williamlin108/Klondike-Connect-4---2026/PCB/3D/TMC2209.step

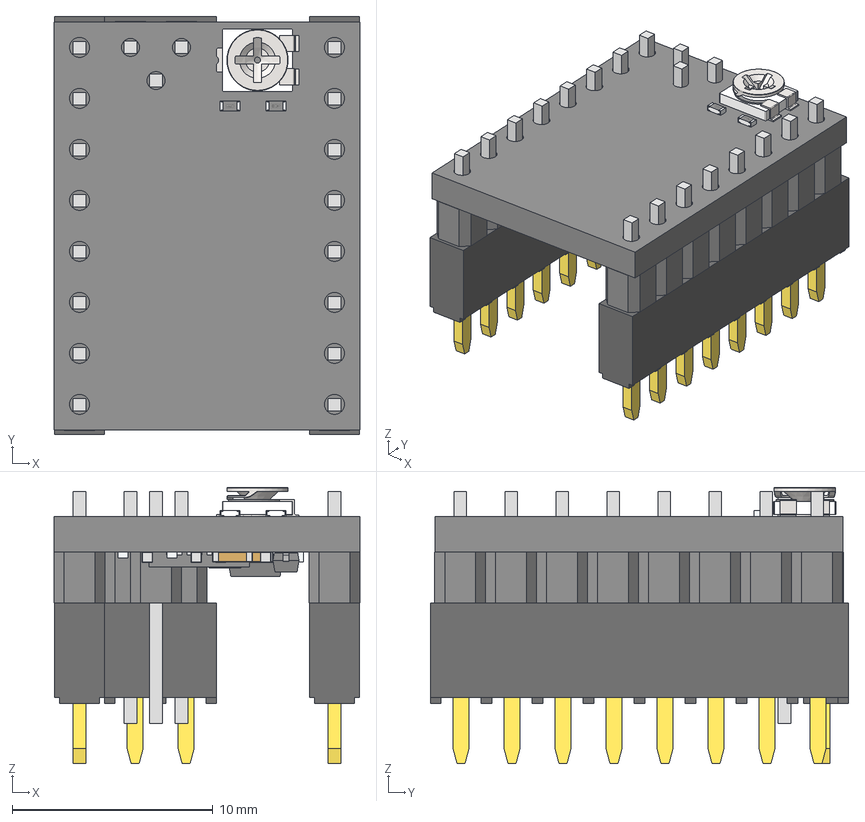
[picture p1: CAD file, 2026-09-19]
PCB/3D/TMC2209.step
15.2 x 20.8 x 13.8 mm
