williamlin108/Klondike-Connect-4---2026/PCB/3D/USB_C_Receptacle_GCT_USB4110.stp

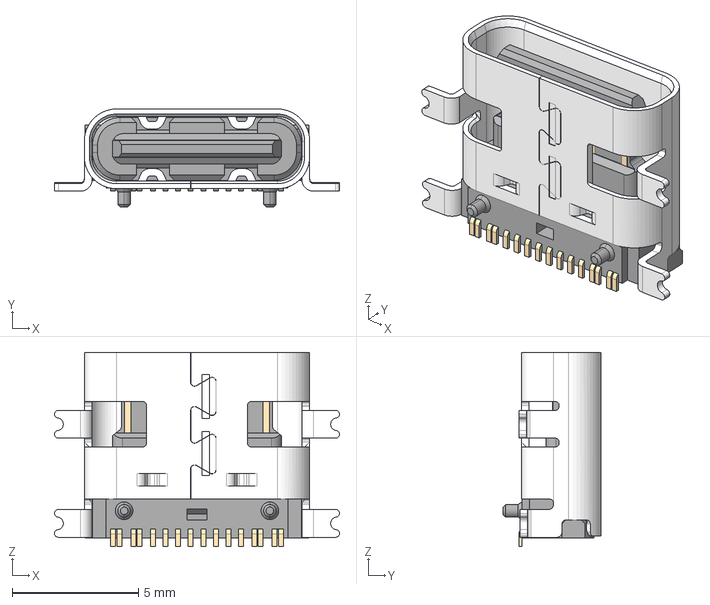
[picture p2: CAD file, 2026-09-18]
PCB/3D/USB_C_Receptacle_GCT_USB4110.stp
11.3 x 3.89 x 7.70 mm
