williamlin108/Klondike-Connect-4---2026/PCB/3D/ESP32-C3-MINI-1-N4.stp

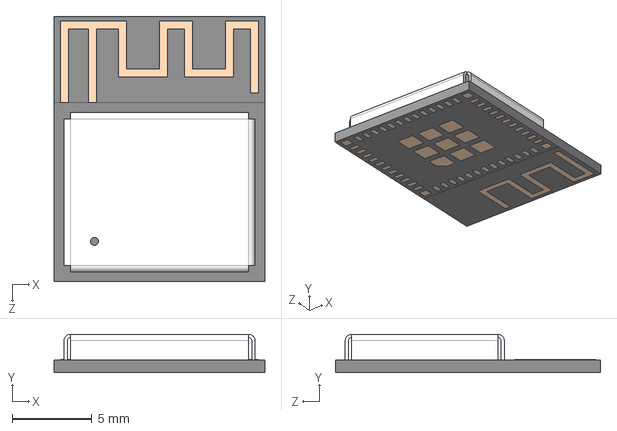
[picture p3: CAD file, 2026-09-18]
PCB/3D/ESP32-C3-MINI-1-N4.stp
13.2 x 2.40 x 16.6 mm
