williamlin108/Klondike-Connect-4---2026/PCB/3D/436500215.STEP

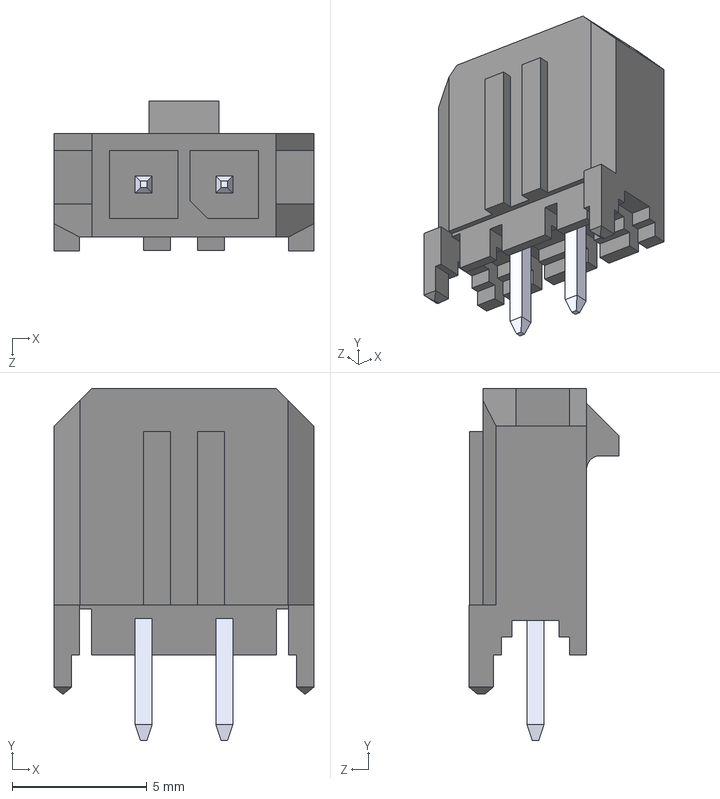
[picture p4: CAD file, 2026-10-14]
PCB/3D/436500215.STEP
9.65 x 13.1 x 5.57 mm
