williamlin108/Klondike-Connect-4---2026/PCB/3D/436500201.stp

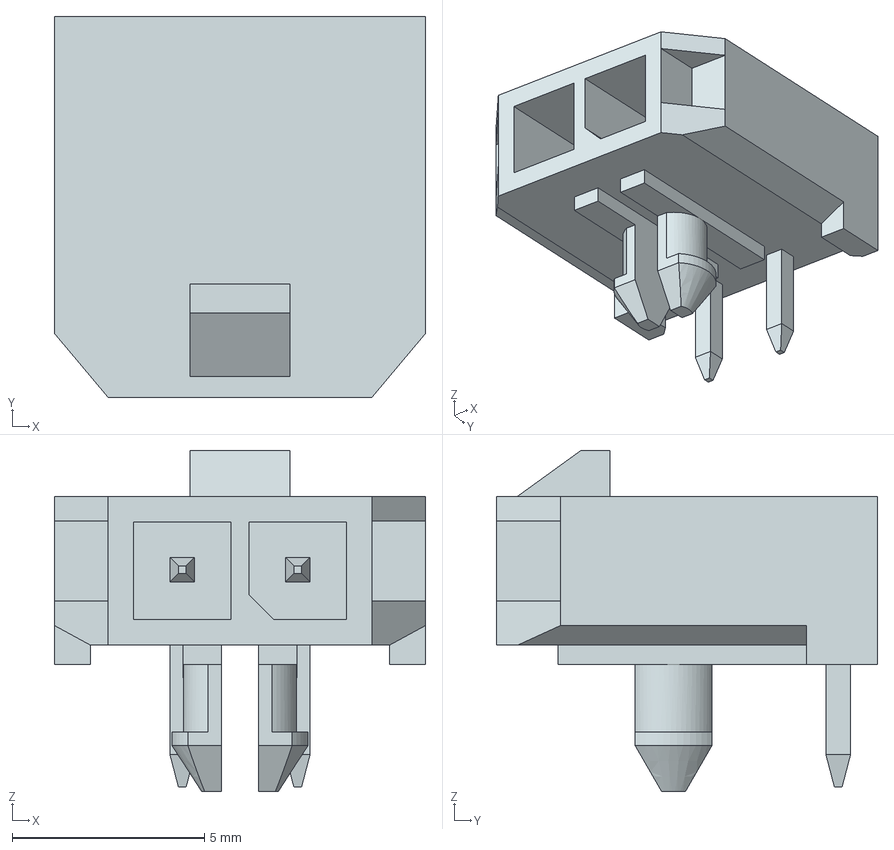
[picture p5: CAD file, 2026-09-19]
PCB/3D/436500201.stp
9.65 x 9.90 x 8.87 mm
