williamlin108/Klondike-Connect-4---2026/PCB/EPICS_Connect4.kicad_pcb

## KiCad design PCB/EPICS_Connect4.kicad_pcb (2026-09-24)

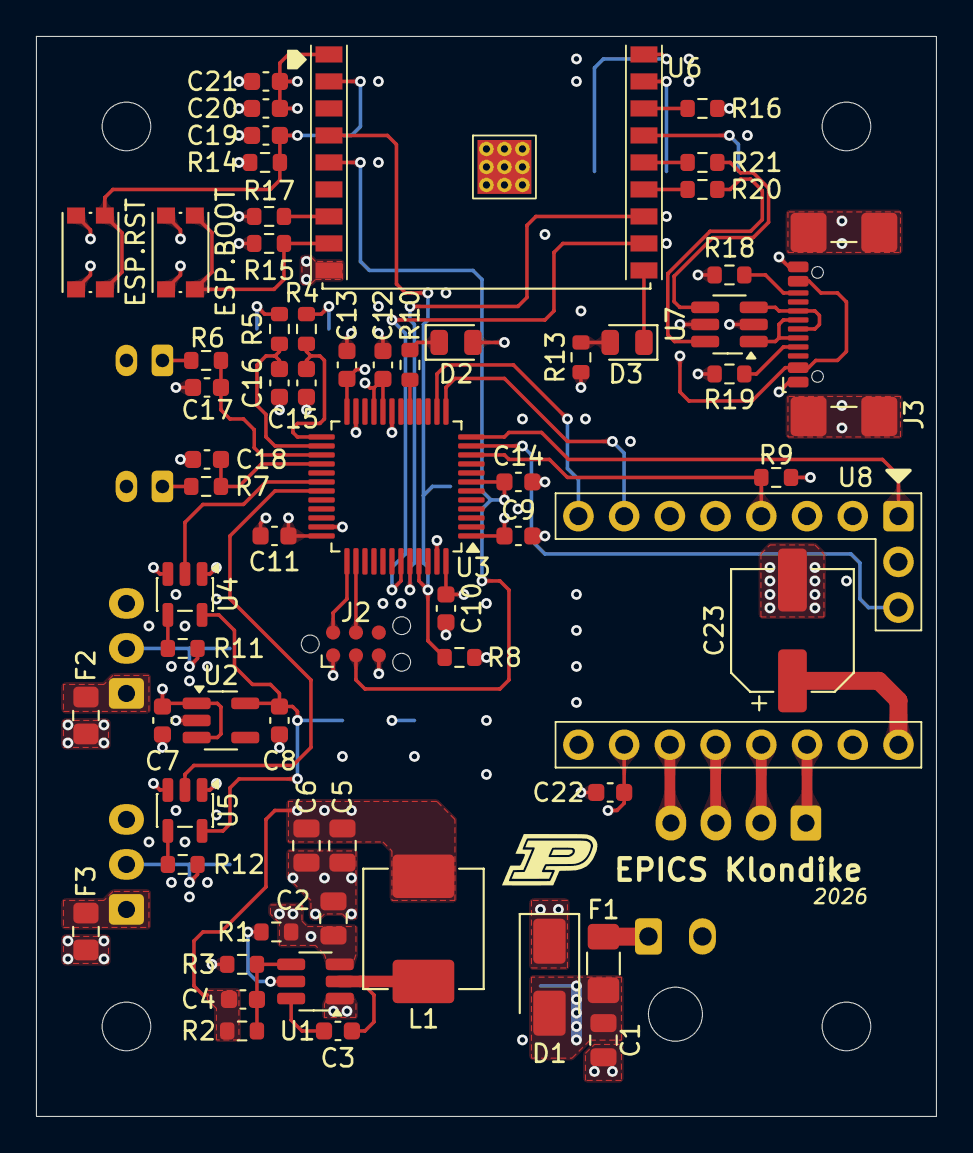
[picture p6: board EPICS_Connect4.kicad_pcb from above]

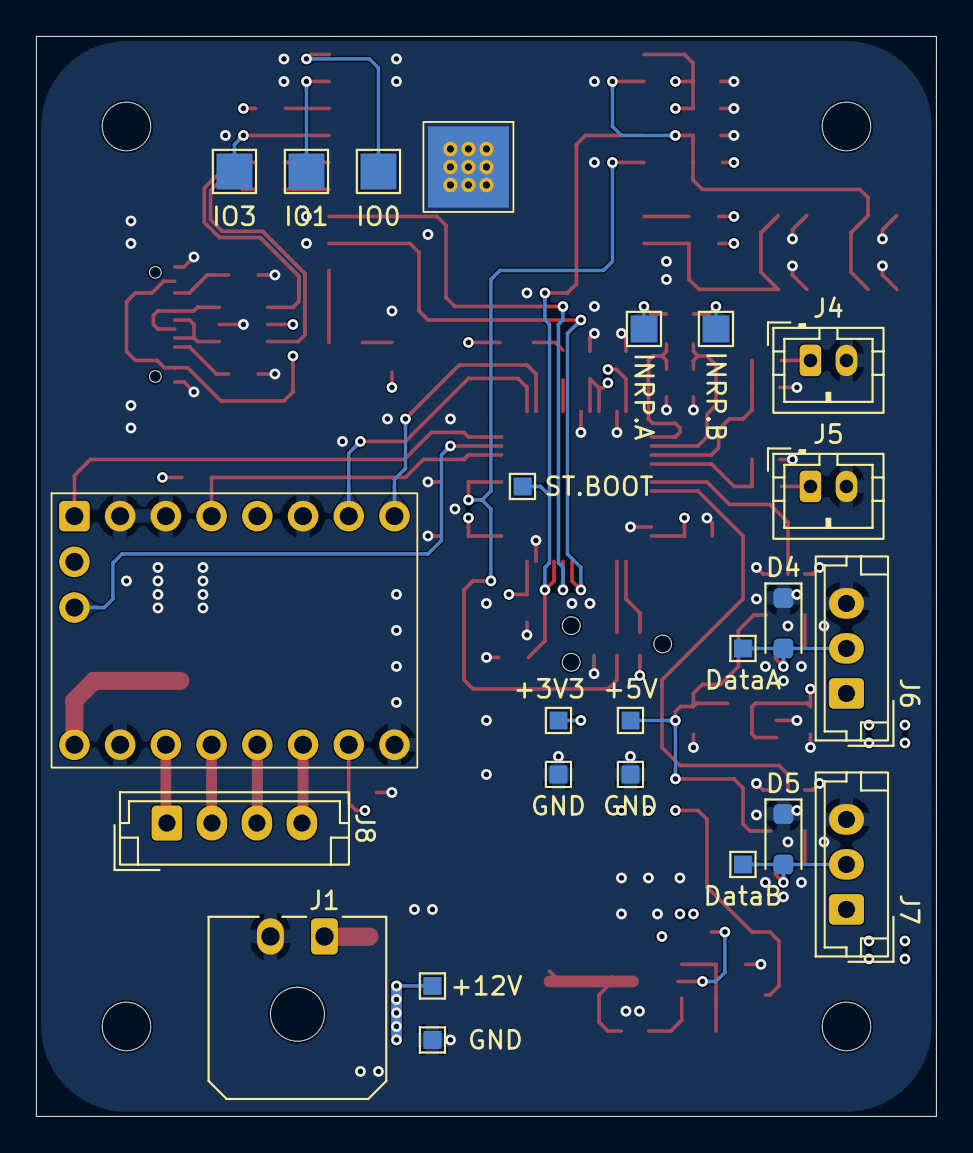
[picture p7: board EPICS_Connect4.kicad_pcb from below]

Board: 4 copper layers, 50.0 x 60.0 mm, 90 parts (22 on the bottom side), 60 nets.

Parts:
C1, C2: 10uF; C_0805_2012Metric
C3, C14, C15, C16, C17, C18: 0.1uF; C_0603_1608Metric
C4: 56pF; C_0603_1608Metric
C5, C6: 22uF; C_0805_2012Metric
C7, C9, C10, C11, C12, C13, C19, C22: 1uF; C_0603_1608Metric
C8, C20, C21: 10uF; C_0603_1608Metric
C23: 100uF; CP_Elec_6.3x5.9
D1: SMAJ12A; D_SMA
D2, D3: 4.5mA @ 1.8V; LED_0805_2012Metric
D4, D5: SMF5.0A; D_SOD-123F
F1: 5A; Fuse_1206_3216Metric_Pad1.42x1.75mm_HandSolder
F2, F3: 2A; Fuse_0805_2012Metric_Pad1.15x1.40mm_HandSolder
H1, H2, H3, H4: MountingHole; MountingHole_2.7mm_M2.5
J1: Power; Molex_Micro-Fit_3.0_43650-0200_1x02_P3.00mm_Horizontal
J2: TC2030; Tag-Connect_TC2030-IDC-NL_2x03_P1.27mm_Vertical
J3: USB_C_Receptacle_USB2.0_14P; USB_C_Receptacle_GCT_USB4110
J4: EndA; JST_PH_B2B-PH-K_1x02_P2.00mm_Vertical
J5: EndB; JST_PH_B2B-PH-K_1x02_P2.00mm_Vertical
J6: LEDA; JST_EH_B3B-EH-A_1x03_P2.50mm_Vertical
J7: LEDB; JST_EH_B3B-EH-A_1x03_P2.50mm_Vertical
J8: Motor; JST_EH_B4B-EH-A_1x04_P2.50mm_Vertical
L1: 10uH; L_Vishay_IHLP-2525
R1: 510k; R_0603_1608Metric
R2: 100k; R_0603_1608Metric
R3: 22.1k; R_0603_1608Metric
R4, R5, R6, R7, R10, R11, R12, R13: 330; R_0603_1608Metric
R8, R14, R15, R16, R17: 10k; R_0603_1608Metric
R9, R18, R19: 5.1k; R_0603_1608Metric
R20, R21: 22; R_0603_1608Metric
SW1: ESP.RST; SW_Push_1P1T_NO_CK_KMR2
SW2: ESP.BOOT; SW_Push_1P1T_NO_CK_KMR2
SYM1: Logo_Open_Hardware_Large; S_Silk_Logo
TP1: +12V; TestPoint_Pad_1.0x1.0mm
TP2, TP4, TP6: GND; TestPoint_Pad_1.0x1.0mm
TP3: +5V; TestPoint_Pad_1.0x1.0mm
TP5: +3V3; TestPoint_Pad_1.0x1.0mm
TP7: ST.BOOT; TestPoint_Pad_1.0x1.0mm
TP8: DataA; TestPoint_Pad_1.0x1.0mm
TP9: DataB; TestPoint_Pad_1.0x1.0mm
TP10: INRP.A; TestPoint_Pad_1.5x1.5mm
TP11: INRP.B; TestPoint_Pad_1.5x1.5mm
TP12: IO0; TestPoint_Pad_2.0x2.0mm
TP13: IO1; TestPoint_Pad_2.0x2.0mm
TP14: IO3; TestPoint_Pad_2.0x2.0mm
U1: TPS54202DDC; SOT-23-6_Handsoldering
U2: AP2205-5; SOT-23-5_HandSoldering
U3: STM32G474CBTx; LQFP-48_7x7mm_P0.5mm
U4, U5: SN74AHCT1G125DBVR; SOT-23-5
U6: ESP32-C3-WROOM-02; ESP32-C3-WROOM-02_Modified
U7: USBLC6-2SC6; SOT-23-6_Handsoldering
U8: TMC2209; STEPSTICK_socket

Connections:
+3V3: C4.2, C5.2, C6.2, C9.1, C10.1, C11.1, C12.1, C13.1, C20.1, C21.1, C22.2, D2.2 (A), J2.1, L1.2, R2.1, R9.1, R13.1, R14.1, R15.1, R16.1, R17.1, TP5.1 (1_1), U3.1 (VBAT), U3.20 (VREF+), U3.21 (VDDA), U3.24 (VDD), U3.36 (VDD), U3.48 (VDD), U6.1 (3V3), U8.15 (VIO)
+5V: C8.2, TP3.1 (1_1), U2.5 (VOUT), U4.5 (VCC), U5.5 (VCC)
+12V: C1.1, C2.2, C7.2, C23.1, D1.2 (A2), F1.2, F2.1, F3.1, R1.1, TP1.1 (1_1), U1.3 (VIN), U2.1 (VIN), U2.3 (EN), U8.9 (VM)
/ESP32 Weblink/D+: R21.2, U6.14 (IO19)
/ESP32 Weblink/D-: R20.2, U6.13 (IO18)
/ESP32 Weblink/D.+: R21.1, U7.4 (I/O2)
/ESP32 Weblink/D.-: R20.1, U7.6 (I/O1)
/ESP32 Weblink/EN: C19.1, R14.2, SW1.2, U6.2 (EN)
/ESP32 Weblink/IO0: TP12.1 (1_1), U6.18 (IO0)
/ESP32 Weblink/IO1: TP13.1 (1_1), U6.17 (IO1)
/ESP32 Weblink/IO2: R16.2, U6.16 (IO2)
/ESP32 Weblink/IO3: TP14.1 (1_1), U6.15 (IO3)
/ESP32 Weblink/IO8: R17.2, U6.7 (IO8)
/ESP32 Weblink/IO9: R15.2, SW2.2, U6.8 (IO9)
/ESP32 Weblink/IO20/RXD: U3.43 (PB6), U6.11 (IO20/RXD)
/ESP32 Weblink/IO21/TXD: U3.44 (PB7), U6.12 (IO21/TXD)
/ESP32 Weblink/LED: D3.1 (K), U6.10 (IO10)
/Motor Acuator/M10: J8.1, U8.11 (A1)
/Motor Acuator/M11: J8.2, U8.12 (A2)
/Motor Acuator/M12: J8.3, U8.13 (B1)
/Motor Acuator/M13: J8.4, U8.14 (B2)
/Motor Acuator/TMC.DIAG: U3.11 (PA3), U8.R (DIAG)
/Motor Acuator/TMC.DIR: U3.14 (PA6), U8.8 (DIR)
/Motor Acuator/TMC.EN: U3.12 (PA4), U8.1 (EN)
/Motor Acuator/TMC.PDN: R9.2, U3.10 (PA2), U8.4 (PDN)
/Motor Acuator/TMC.STEP: U3.13 (PA5), U8.7 (STEP)
/STM32 Controller/BOOT: R8.1, TP7.1 (1_1), U3.45 (PB8), U6.4 (IO5)
/STM32 Controller/END.A: J4.1, R6.1
/STM32 Controller/END.A*: C17.1, R6.2, U3.27 (PB13)
/STM32 Controller/END.B: J5.1, R7.1
/STM32 Controller/END.B*: C18.1, R7.2, U3.28 (PB14)
/STM32 Controller/INRP.A: R4.1, TP10.1 (1_1)
/STM32 Controller/INRP.A*: C15.1, R4.2, U3.25 (PB11)
/STM32 Controller/INRP.B: R5.1, TP11.1 (1_1)
/STM32 Controller/INRP.B*: C16.1, R5.2, U3.26 (PB12)
/STM32 Controller/LED.A: U3.30 (PA8), U4.2 (A)
/STM32 Controller/LED.B: U3.31 (PA9), U5.2 (A)
/STM32 Controller/NRST: C14.1, J2.3, U3.7 (PG10), U6.5 (IO6)
/STM32 Controller/SWCLK: J2.4, U3.38 (PA14)
/STM32 Controller/SWDIO: J2.2, U3.37 (PA13)
/STM32 Controller/U_LED: R10.2, U3.17 (PB1)
/STM32 Controller/ledDataA: D4.2 (A2), J6.2, R11.2, TP8.1 (1_1)
/STM32 Controller/ledDataB: D5.2 (A2), J7.2, R12.2, TP9.1 (1_1)
GND: C1.2, C2.1, C5.1, C6.1, C7.1, C8.1, C9.2, C10.2, C11.2, C12.2, C13.2, C14.2, C15.2, C16.2, C17.2, C18.2, C19.2, C20.2, C21.2, C22.1, C23.2, D1.1 (A1), D4.1 (A1), D5.1 (A1), J1.2, J2.5, J3.A1 (GND), J3.A12 (GND), J3.B1 (GND), J3.B12 (GND), J3.SH (SHIELD), J4.2, J5.2, J6.3, J7.3, R3.2, R8.2, R18.2, R19.2, SW1.1, SW2.1, TP2.1 (1_1), TP4.1 (1_1), TP6.1 (1_1), U1.1 (GND), U2.2 (GND), U3.19 (VSSA), U3.23 (VSS), U3.35 (VSS), U3.47 (VSS), U4.1 (~OE), U4.3 (GND), U5.1 (~OE), U5.3 (GND), U6.9 (GND), U6.19 (GND), U7.2 (GND), U8.2 (MS1), U8.3 (MS2), U8.6 (CLK), U8.10 (GND), U8.16 (GND)
unnamed: D2.1 (K), R10.1
unnamed: D3.2 (A), R13.2
unnamed: F1.1, J1.1
unnamed: J3.A5 (CC1), R19.1
unnamed: J3.B5 (CC2), R18.1
unnamed: J3.A6 (D+), J3.B6 (D+), U7.3 (I/O2)
unnamed: J3.A7 (D-), J3.B7 (D-), U7.1 (I/O1)
unnamed: F2.2, J6.1
unnamed: F3.2, J7.1
unnamed: C3.1, U1.6 (BOOT)
unnamed: R1.2, U1.5 (EN)
unnamed: C4.1, R2.2, R3.1, U1.4 (FB)
unnamed: C3.2, L1.1, U1.2 (SW)
unnamed: R11.1, U4.4 (Y)
unnamed: R12.1, U5.4 (Y)
unnamed: J3.A4 (VBUS), J3.A9 (VBUS), J3.B4 (VBUS), J3.B9 (VBUS), U7.5 (VBUS)
