williamlin108/Klondike-Connect-4---2026/(commit log)

2026-09-18 Initial commit: EPICS_Connect4 KiCad project
    [EPICS_Connect4.kicad_pcb, EPICS_Connect4.kicad_sch, ESP32-C3-MINI-1-N4.stp, USB_C_Receptacle_GCT_USB4110.stp, esp32.kicad_sch, motor.kicad_sch, power.kicad_sch, stm32.kicad_sch]
2026-09-18 Reorganize repo: move KiCad files into PCB/, add empty Firmware/ folders
    Moves all existing KiCad project files into PCB/ and adds empty
    Firmware/ESP32 and Firmware/STM32 folders (with .gitkeep placeholders)
    for upcoming firmware work.
    [EPICS_Connect4.kicad_pcb, EPICS_Connect4.kicad_sch, ESP32-C3-MINI-1-N4.stp, USB_C_Receptacle_GCT_USB4110.stp, esp32.kicad_sch, motor.kicad_sch, power.kicad_sch, stm32.kicad_sch]
2026-09-19 Update EPICS_Connect4 KiCad project
    [436500201.stp, EPICS_Connect4.kicad_pcb, EPICS_Connect4.kicad_sch, TMC2209.step, esp32.kicad_sch, motor.kicad_sch, power.kicad_sch, stm32.kicad_sch]
2026-09-19 Remove top copper pour
    [EPICS_Connect4.kicad_pcb]
2026-09-19 Update layout: restore zone min_clearance, set design rule minimums, tweaks
    [EPICS_Connect4.kicad_pcb]
2026-09-19 Update PCB layout, ESP32 schematic, and fab outputs
    [EPICS_Connect4-B_Cu.gbr, EPICS_Connect4-B_Mask.gbr, EPICS_Connect4-B_Paste.gbr, EPICS_Connect4-B_Silkscreen.gbr, EPICS_Connect4-Edge_Cuts.gbr, EPICS_Connect4-F_Cu.gbr, EPICS_Connect4-F_Mask.gbr, EPICS_Connect4-F_Paste.gbr]
2026-09-19 Update EPICS_Connect4 PCB layout
    [EPICS_Connect4.kicad_pcb]
2026-09-19 Remove FabOutputs from repo
    [EPICS_Connect4-B_Cu.gbr, EPICS_Connect4-B_Mask.gbr, EPICS_Connect4-B_Paste.gbr, EPICS_Connect4-B_Silkscreen.gbr, EPICS_Connect4-Edge_Cuts.gbr, EPICS_Connect4-F_Cu.gbr, EPICS_Connect4-F_Mask.gbr, EPICS_Connect4-F_Paste.gbr]
2026-09-20 Update PCB layout and project settings, add STEP export
    [EPICS_Connect4.kicad_pcb]
2026-09-20 Minor PCB updates
    [EPICS_Connect4.kicad_pcb, esp32.kicad_sch, power.kicad_sch]
2026-09-20 More PCB edits
    [EPICS_Connect4.kicad_pcb]
2026-09-20 Update PCB layout
    [EPICS_Connect4.kicad_pcb]
2026-09-24 Use project-relative paths for 3D models and fab output
    [EPICS_Connect4.kicad_pcb]
2026-09-28 Swap Molex connector 3D model to 43650-0215
    [436500201.stp, 436500215.STEP, EPICS_Connect4.csv, EPICS_Connect4.kicad_pcb, EPICS_Connect4.kicad_sch, esp32.kicad_sch, motor.kicad_sch, power.kicad_sch]
2026-10-01 Ready for Fab
    [EPICS_Connect4.csv, EPICS_Connect4.kicad_pcb, EPICS_Connect4.kicad_sch, esp32.kicad_sch, motor.kicad_sch, stm32.kicad_sch]
2026-10-02 text fixes
    [EPICS_Connect4.kicad_pcb]
2026-10-14 Update PCB fabrication status to completed
